Froggy111/filament-extruder/README.md

# Filament Extruder

fully closed loop FDM filameent production machine
