Froggy111/filament-extruder/hardware/control-board/control-board.kicad_pcb

## KiCad design hardware/control-board/control-board.kicad_pcb (2026-01-01)

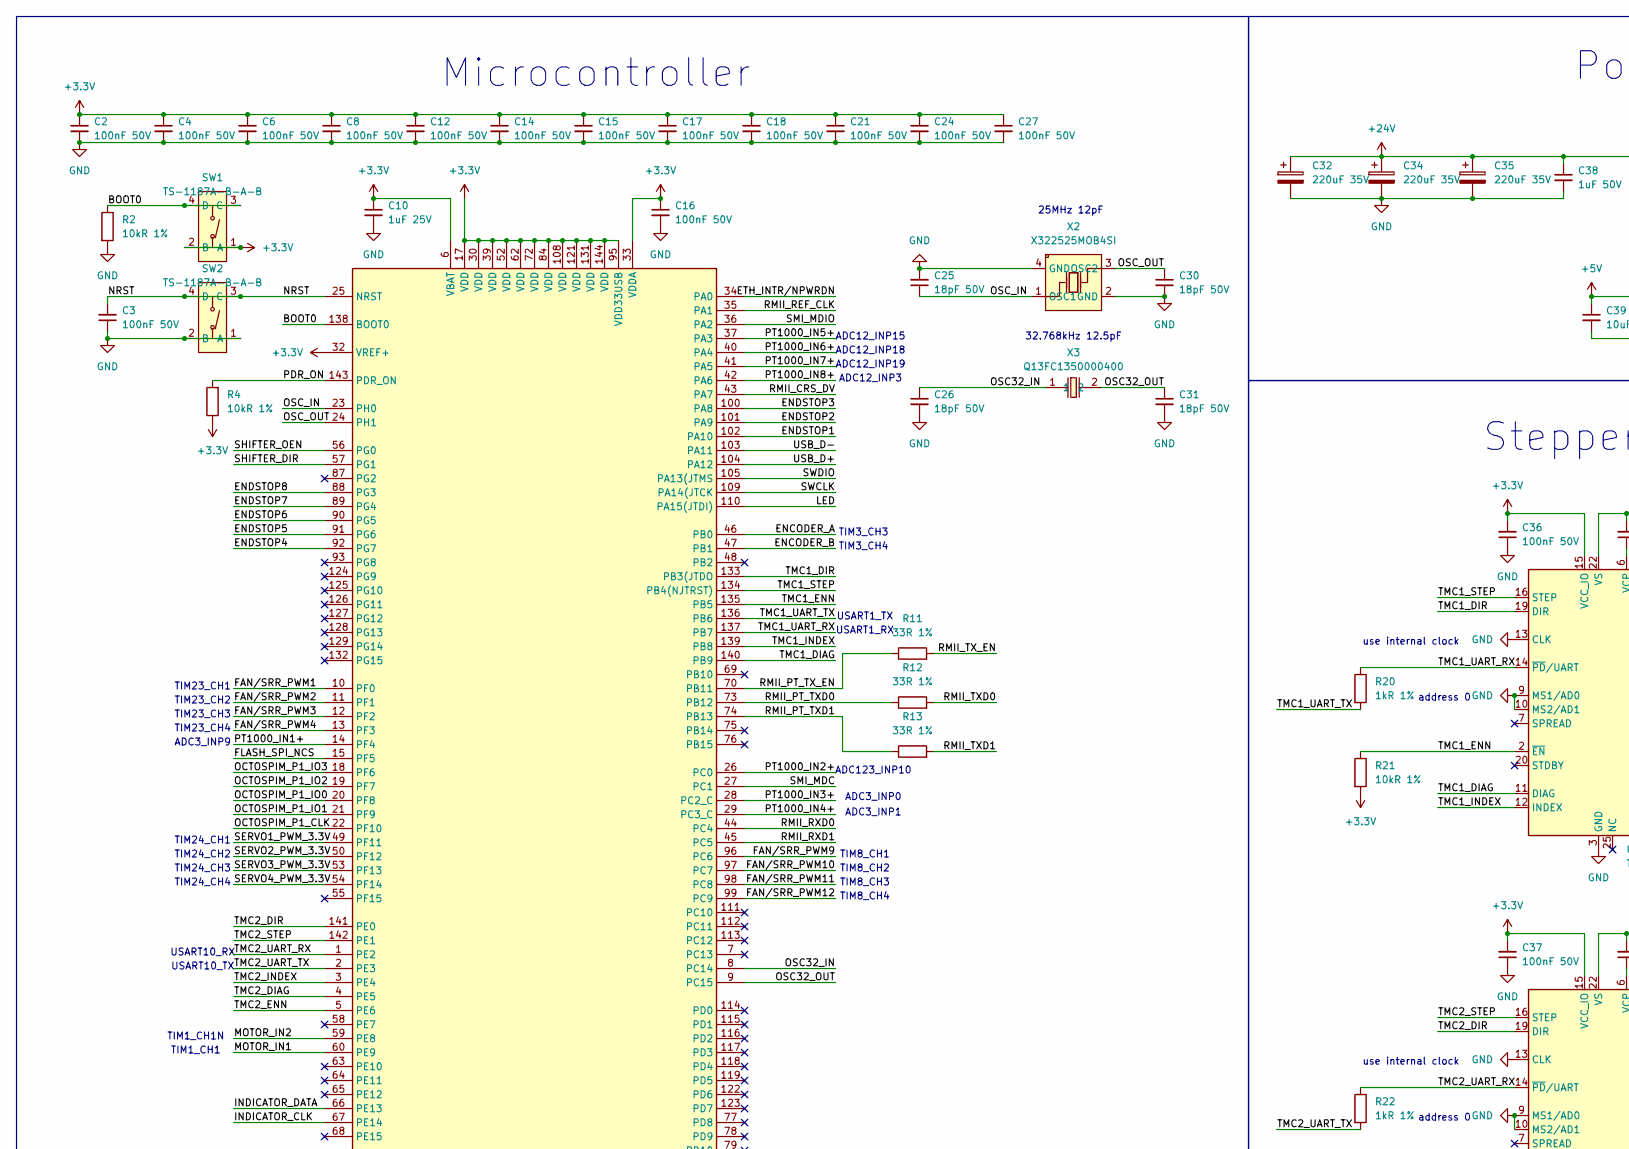
[picture p1: schematic control-board.kicad_sch, part in row 1, column 1]

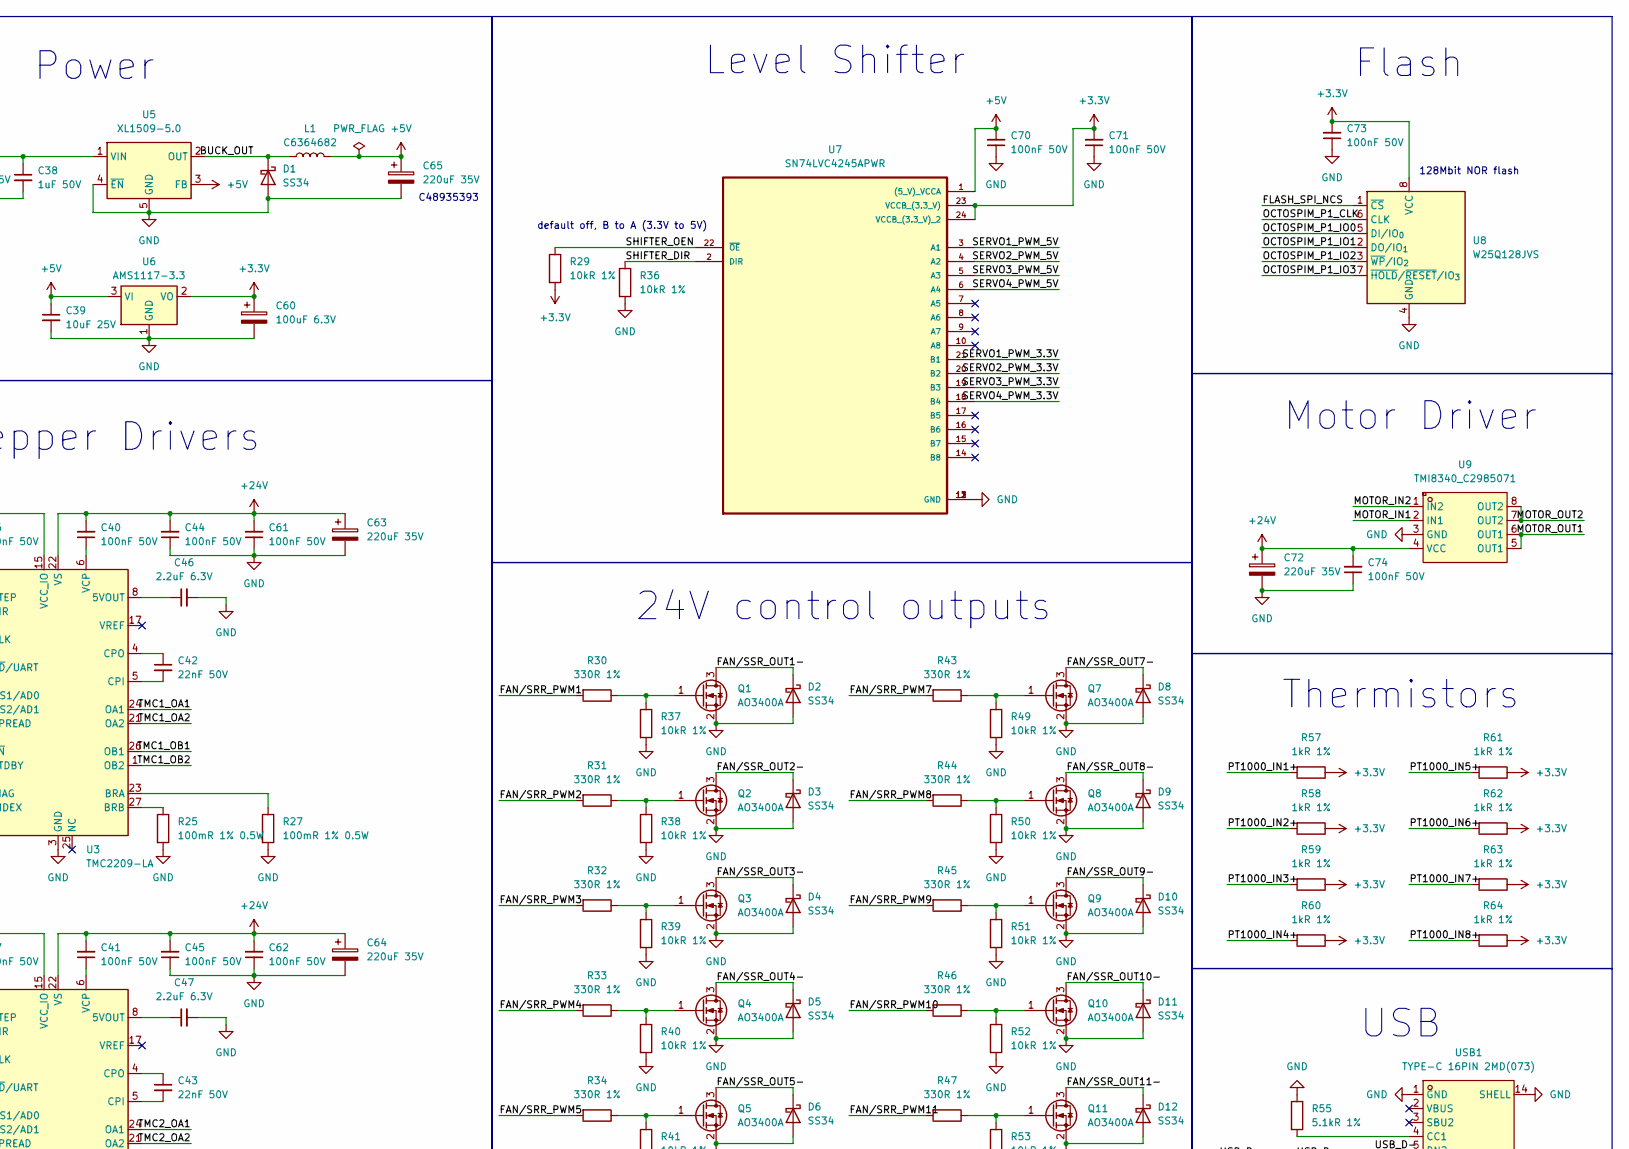
[picture p2: schematic control-board.kicad_sch, part in row 1, column 2]

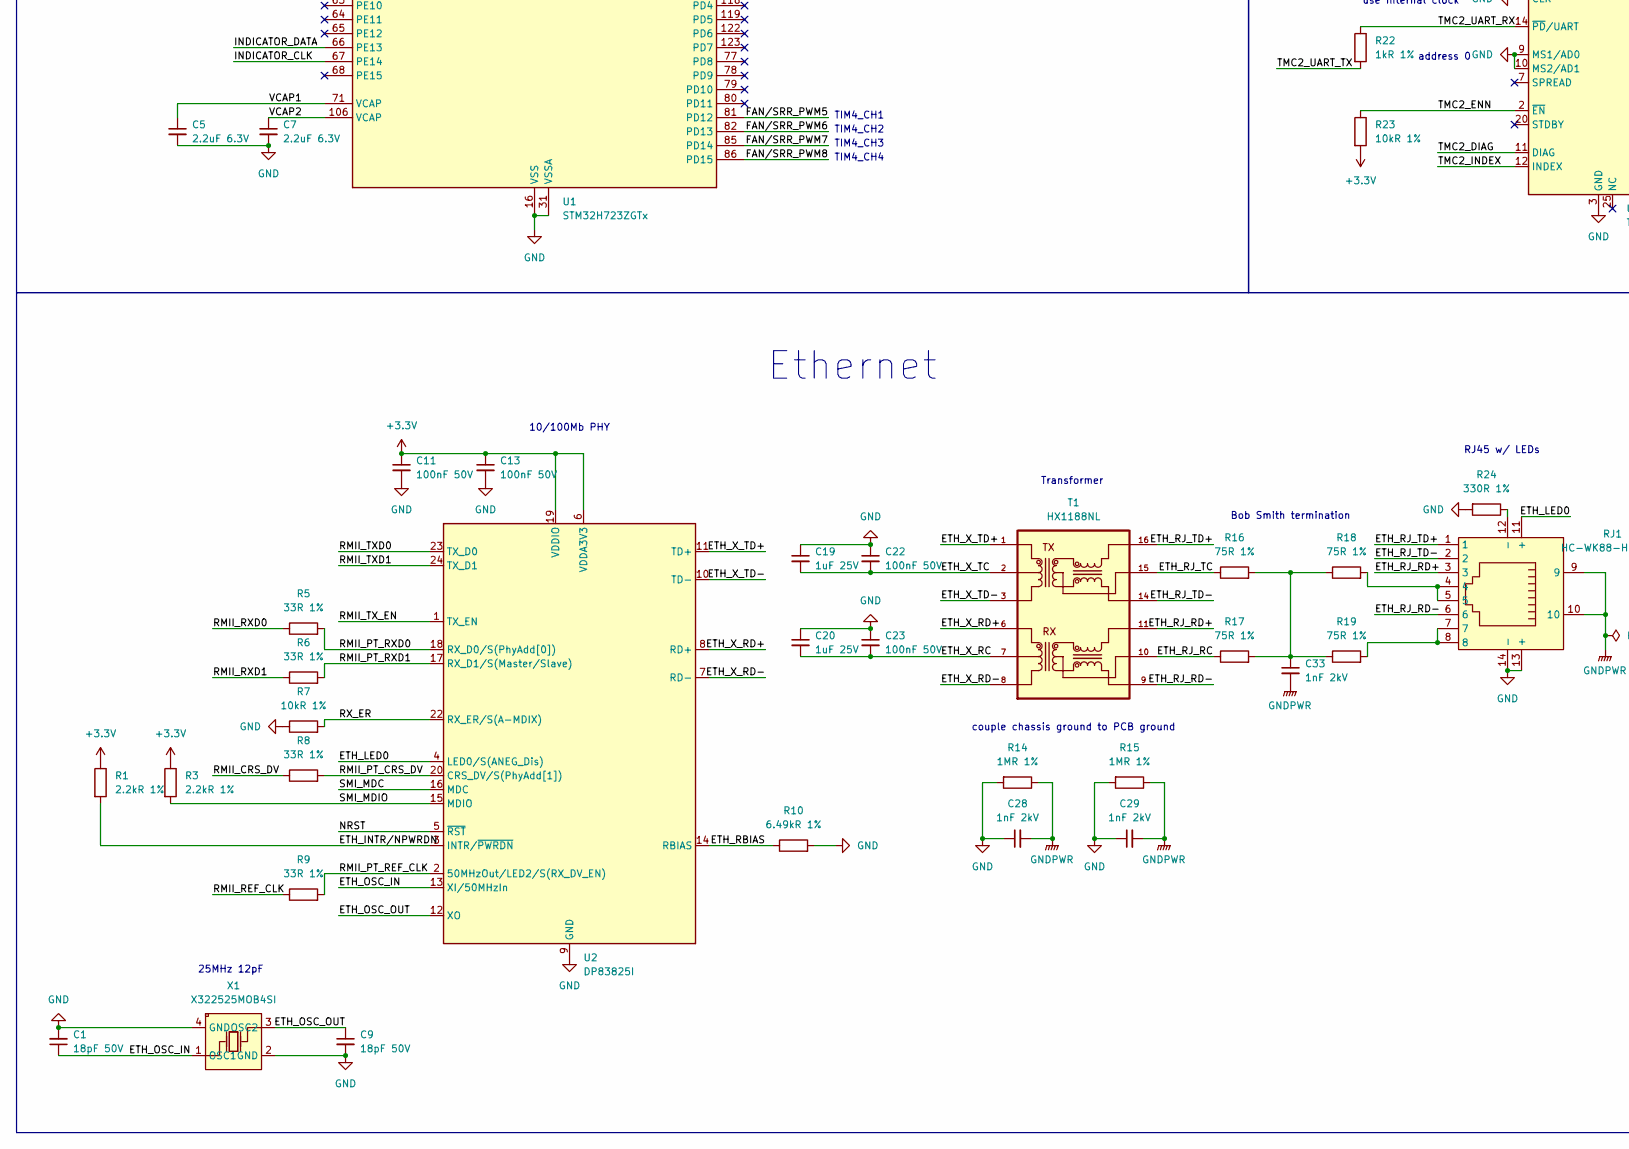
[picture p3: schematic control-board.kicad_sch, part in row 2, column 1]

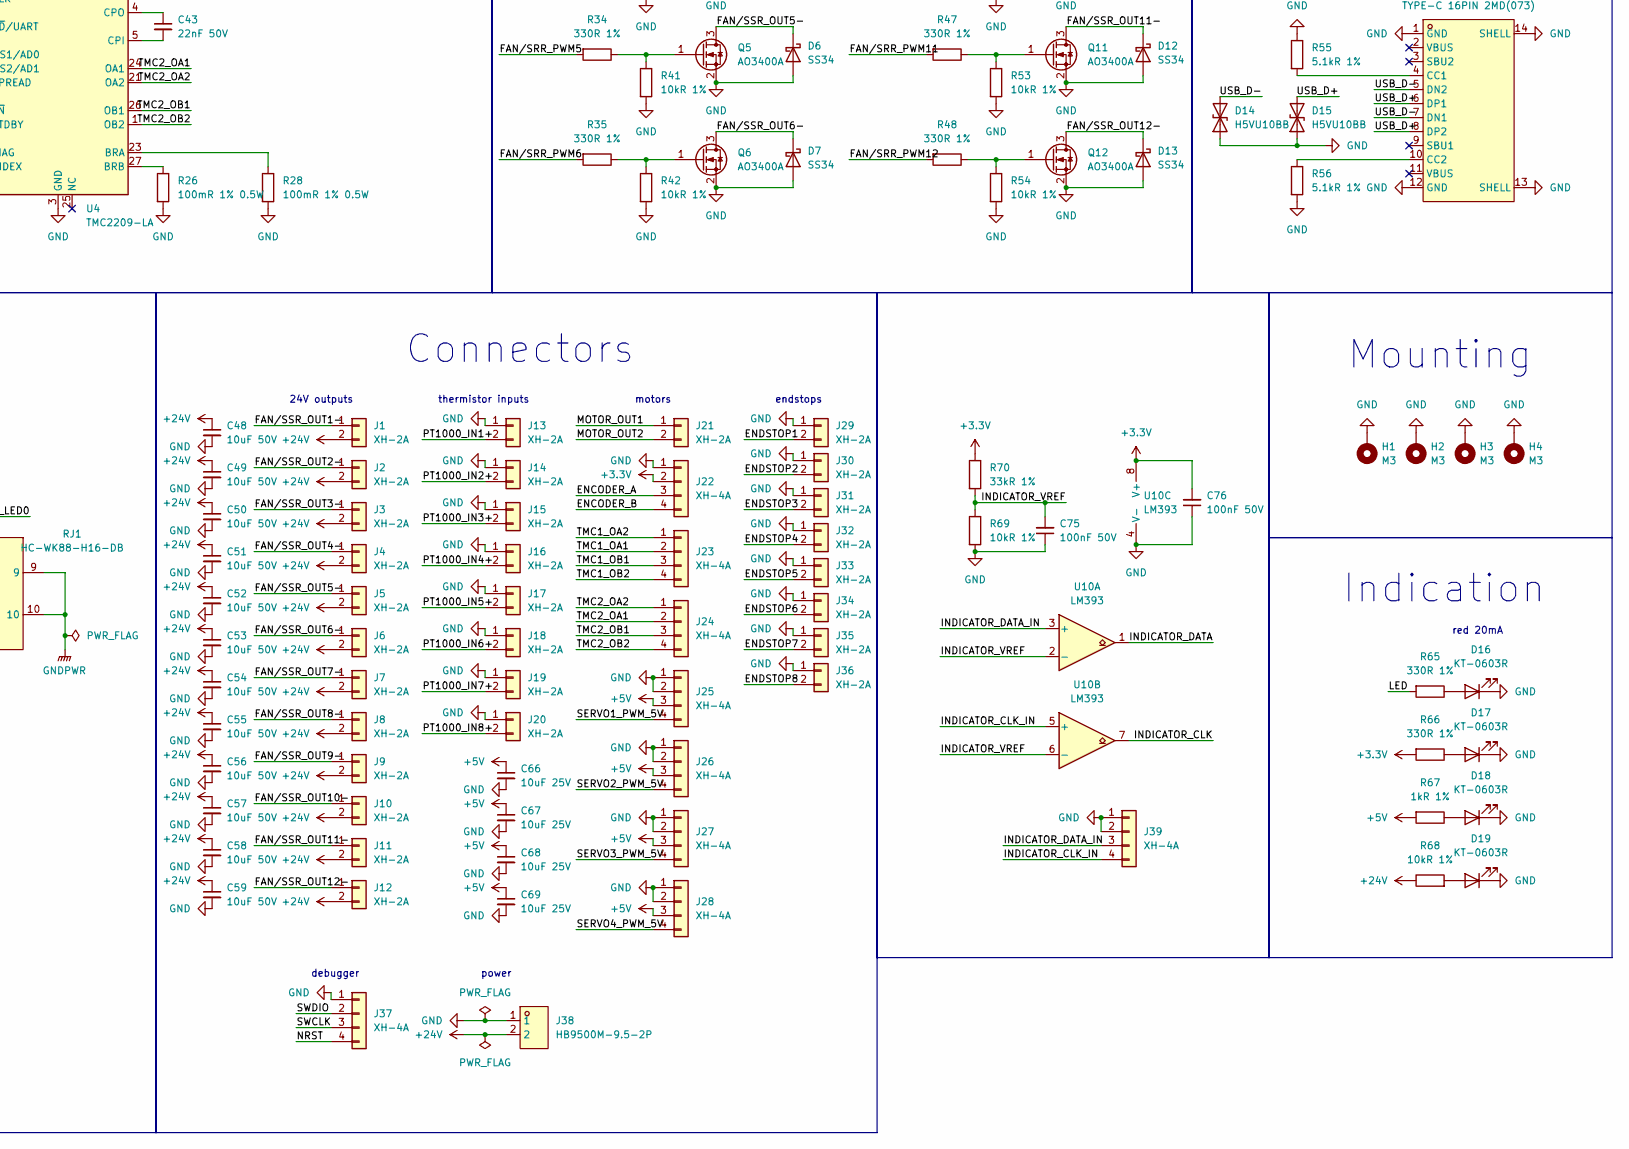
[picture p4: schematic control-board.kicad_sch, part in row 2, column 2]

Parts:
C1, C9, C25, C26, C30, C31: 18pF 50V; C_0402_1005Metric
C2, C3, C4, C6, C8, C11, C12, C13, C14, C15, C16, C17, C18, C21, C22, C23, C24, C27, C36, C37, C40, C41, C44, C45, C61, C62, C70, C71, C73, C74, C75, C76: 100nF 50V; C_0402_1005Metric
C5, C7, C46, C47: 2.2uF 6.3V; C_0402_1005Metric
C10, C19, C20: 1uF 25V; C_0402_1005Metric
C28, C29, C33: 1nF 2kV; C_1206_3216Metric
C32, C34, C35, C63, C64, C65, C72: 220uF 35V; CP_Elec_8x10.5
C38: 1uF 50V; C_0603_1608Metric
C39, C66, C67, C68, C69: 10uF 25V; C_0603_1608Metric
C42, C43: 22nF 50V; C_0402_1005Metric
C48, C49, C50, C51, C52, C53, C54, C55, C56, C57, C58, C59: 10uF 50V; C_1206_3216Metric
C60: 100uF 6.3V; CP_EIA-3528-21_Kemet-B
D1, D2, D3, D4, D5, D6, D7, D8, D9, D10, D11, D12, D13: SS34; D_SMA
D14, D15: H5VU10BB; D_SOD-882
D16, D17, D18, D19: KT-0603R; LED_0603_1608Metric
H1, H2, H3, H4: M3; MountingHole_3.2mm_M3_Pad_Via
J1, J2, J3, J4, J5, J6, J7, J8, J9, J10, J11, J12, J13, J14, J15, J16, J17, J18, J19, J20, J21, J29, J30, J31, J32, J33, J34, J35, J36: XH-2A; JST_XH_B2B-XH-A_1x02_P2.50mm_Vertical
J22, J23, J24, J25, J26, J27, J28, J37, J39: XH-4A; JST_XH_B4B-XH-A_1x04_P2.50mm_Vertical
J38: HB9500M-9.5-2P; CONN-TH_HB9500M-9.5-2P; LCSC Part C601239
L1: C6364682; L_Chilisin_BMRF00101040
Q1, Q2, Q3, Q4, Q5, Q6, Q7, Q8, Q9, Q10, Q11, Q12: AO3400A; SOT-23
R1, R3: 2.2kR 1%; R_0402_1005Metric
R2, R4, R7, R21, R23, R29, R36, R37, R38, R39, R40, R41, R42, R49, R50, R51, R52, R53, R54, R68, R69: 10kR 1%; R_0402_1005Metric
R5, R6, R8, R9, R11, R12, R13: 33R 1%; R_0402_1005Metric
R10: 6.49kR 1%; R_0402_1005Metric
R14, R15: 1MR 1%; R_1206_3216Metric
R16, R17, R18, R19: 75R 1%; R_0402_1005Metric
R20, R22, R57, R58, R59, R60, R61, R62, R63, R64, R67: 1kR 1%; R_0402_1005Metric
R24, R30, R31, R32, R33, R34, R35, R43, R44, R45, R46, R47, R48, R65, R66: 330R 1%; R_0402_1005Metric
R25, R26, R27, R28: 100mR 1% 0.5W; R_1206_3216Metric
R55, R56: 5.1kR 1%; R_0402_1005Metric
R70: 33kR 1%; R_0402_1005Metric
RJ1: HC-WK88-H16-DB; RJ45-TH_HC-WK88-H16-DB; LCSC Part C7501824
SW1, SW2: TS-1187A-B-A-B; SW-SMD_4P-L5.1-W5.1-P3.70-LS6.5-TL_H1.5; LCSC Part C318884
T1: HX1188NL; HXXXX
U1: STM32H723ZGTx; LQFP-144_20x20mm_P0.5mm
U2: DP83825I; Texas_RMQ0024A_WQFN-24-1EP_3x3mm_P0.4mm_EP1.9x1.9mm
U3, U4: TMC2209-LA; VQFN-28-1EP_5x5mm_P0.5mm_EP3.7x3.7mm_ThermalVias
U5: XL1509-5.0; SOIC-8_3.9x4.9mm_P1.27mm
U6: AMS1117-3.3; SOT-223-3_TabPin2
U7: SN74LVC4245APWR; SOP65P640X120-24N
U8: W25Q128JVS; SOIC-8_5.3x5.3mm_P1.27mm
U9: TMI8340_C2985071; SOP-8_L4.9-W3.9-P1.27-LS6.0-BL-1; LCSC Part C2985071
U10: LM393; SOIC-8_3.9x4.9mm_P1.27mm
USB1: TYPE-C 16PIN 2MD(073); USB-C-SMD_TYPE-C-6PIN-2MD-073; LCSC Part C2765186
X1, X2: X322525MOB4SI; CRYSTAL-SMD_4P-L3.2-W2.5-BL; LCSC Part C9006
X3: Q13FC1350000400; FC-135R_L3.2-W1.5; LCSC Part C32346

Connections:
+3.3V: C2.1, C4.1, C6.1, C8.1, C10.1, C11.1, C12.1, C13.1, C14.1, C15.1, C16.1, C17.1, C18.1, C21.1, C24.1, C27.1, C36.2, C37.2, C60.1, C71.2, C73.2, C76.2, J22.2, R1.1, R3.1, R4.1, R21.2, R23.2, R29.2, R57.1, R58.1, R59.1, R60.1, R61.1, R62.1, R63.1, R64.1, R66.2, R70.1, SW1.1 (A), SW1.2 (B), U1.6 (VBAT), U1.17 (VDD), U1.30 (VDD), U1.32 (VREF+), U1.33 (VDDA), U1.39 (VDD), U1.52 (VDD), U1.62 (VDD), U1.72 (VDD), U1.84 (VDD), U1.95 (VDD33USB), U1.108 (VDD), U1.121 (VDD), U1.131 (VDD), U1.144 (VDD), U2.6 (VDDA3V3), U2.19 (VDDIO), U3.15 (VCC_IO), U4.15 (VCC_IO), U6.2 (VO), U7.23 (VCCB_(3.3_V)), U7.24 (VCCB_(3.3_V)_2), U8.8 (VCC), U10.8 (V+)
+5V: C39.1, C65.1, C66.1, C67.1, C68.1, C69.1, C70.2, J25.3, J26.3, J27.3, J28.3, L1.2, R67.2, U5.3 (FB), U6.3 (VI), U7.1 ((5_V)_VCCA)
+24V: C32.1, C34.1, C35.1, C38.1, C40.2, C41.2, C44.2, C45.2, C48.1, C49.1, C50.1, C51.1, C52.1, C53.1, C54.1, C55.1, C56.1, C57.1, C58.1, C59.1, C61.2, C62.2, C63.1, C64.1, C72.1, C74.2, J1.2, J2.2, J3.2, J4.2, J5.2, J6.2, J7.2, J8.2, J9.2, J10.2, J11.2, J12.2, J38.2, R68.1, U3.22 (VS), U3.28 (VS), U4.22 (VS), U4.28 (VS), U5.1 (VIN), U9.4 (VCC)
/BOOT0: R2.1, SW1.3 (C), SW1.4 (D), U1.138 (BOOT0)
/BUCK_OUT: D1.1 (K), L1.1, U5.2 (OUT)
/ENCODER_A: J22.3, U1.46 (PB0)
/ENCODER_B: J22.4, U1.47 (PB1)
/ENDSTOP1: J29.2, U1.102 (PA10)
/ENDSTOP2: J30.2, U1.101 (PA9)
/ENDSTOP3: J31.2, U1.100 (PA8)
/ENDSTOP4: J32.2, U1.92 (PG7)
/ENDSTOP5: J33.2, U1.91 (PG6)
/ENDSTOP6: J34.2, U1.90 (PG5)
/ENDSTOP7: J35.2, U1.89 (PG4)
/ENDSTOP8: J36.2, U1.88 (PG3)
/ETH_INTR/NPWRDN: R1.2, U1.34 (PA0), U2.3 (INTR/~PWRDN)
/ETH_LED0: RJ1.11 (+), U2.4 (LED0/S(ANEG_Dis))
/ETH_OSC_IN: C1.1, U2.13 (XI/50MHzIn), X1.1 (OSC1)
/ETH_OSC_OUT: C9.1, U2.12 (XO), X1.3 (OSC2)
/ETH_RBIAS: R10.1, U2.14 (RBIAS)
/ETH_RJ_RC: R17.1, T1.10
/ETH_RJ_RD+: RJ1.3, T1.11
/ETH_RJ_RD-: RJ1.6, T1.9
/ETH_RJ_TC: R16.1, T1.15
/ETH_RJ_TD+: RJ1.1, T1.16
/ETH_RJ_TD-: RJ1.2, T1.14
/ETH_X_RC: C20.2, C23.2, T1.7
/ETH_X_RD+: T1.6, U2.8 (RD+)
/ETH_X_RD-: T1.8, U2.7 (RD-)
/ETH_X_TC: C19.2, C22.2, T1.2
/ETH_X_TD+: T1.1, U2.11 (TD+)
/ETH_X_TD-: T1.3, U2.10 (TD-)
/FAN/SRR_PWM1: R30.2, U1.10 (PF0)
/FAN/SRR_PWM2: R31.2, U1.11 (PF1)
/FAN/SRR_PWM3: R32.2, U1.12 (PF2)
/FAN/SRR_PWM4: R33.2, U1.13 (PF3)
/FAN/SRR_PWM5: R34.2, U1.81 (PD12)
/FAN/SRR_PWM6: R35.2, U1.82 (PD13)
/FAN/SRR_PWM7: R43.2, U1.85 (PD14)
/FAN/SRR_PWM8: R44.2, U1.86 (PD15)
/FAN/SRR_PWM9: R45.2, U1.96 (PC6)
/FAN/SRR_PWM10: R46.2, U1.97 (PC7)
/FAN/SRR_PWM11: R47.2, U1.98 (PC8)
/FAN/SRR_PWM12: R48.2, U1.99 (PC9)
/FAN/SSR_OUT1-: D2.1 (K), J1.1, Q1.3 (D)
/FAN/SSR_OUT2-: D3.1 (K), J2.1, Q2.3 (D)
/FAN/SSR_OUT3-: D4.1 (K), J3.1, Q3.3 (D)
/FAN/SSR_OUT4-: D5.1 (K), J4.1, Q4.3 (D)
/FAN/SSR_OUT5-: D6.1 (K), J5.1, Q5.3 (D)
/FAN/SSR_OUT6-: D7.1 (K), J6.1, Q6.3 (D)
/FAN/SSR_OUT7-: D8.1 (K), J7.1, Q7.3 (D)
/FAN/SSR_OUT8-: D9.1 (K), J8.1, Q8.3 (D)
/FAN/SSR_OUT9-: D10.1 (K), J9.1, Q9.3 (D)
/FAN/SSR_OUT10-: D11.1 (K), J10.1, Q10.3 (D)
/FAN/SSR_OUT11-: D12.1 (K), J11.1, Q11.3 (D)
/FAN/SSR_OUT12-: D13.1 (K), J12.1, Q12.3 (D)
/FLASH_SPI_NCS: U1.15 (PF5), U8.1 (~CS)
/INDICATOR_CLK: U1.67 (PE14), U10.7
/INDICATOR_CLK_IN: J39.4, U10.5 (+)
/INDICATOR_DATA: U1.66 (PE13), U10.1
/INDICATOR_DATA_IN: J39.3, U10.3 (+)
/INDICATOR_VREF: C75.2, R69.1, R70.2, U10.2 (-), U10.6 (-)
/LED: R65.2, U1.110 (PA15(JTDI))
/MOTOR_IN1: U1.60 (PE9), U9.2 (IN1)
/MOTOR_IN2: U1.59 (PE8), U9.1 (IN2)
/MOTOR_OUT1: J21.1, U9.5 (OUT1), U9.6 (OUT1)
/MOTOR_OUT2: J21.2, U9.7 (OUT2), U9.8 (OUT2)
/NRST: C3.2, J37.4, SW2.3 (C), SW2.4 (D), U1.25 (NRST), U2.5 (~RST)
/OCTOSPIM_P1_CLK: U1.22 (PF10), U8.6 (CLK)
/OCTOSPIM_P1_IO0: U1.20 (PF8), U8.5 (DI/IO_{0})
/OCTOSPIM_P1_IO1: U1.21 (PF9), U8.2 (DO/IO_{1})
/OCTOSPIM_P1_IO2: U1.19 (PF7), U8.3 (~WP/IO_{2})
/OCTOSPIM_P1_IO3: U1.18 (PF6), U8.7 (~HOLD/~RESET/IO_{3})
/OSC32_IN: C26.1, U1.8 (PC14), X3.1
/OSC32_OUT: C31.1, U1.9 (PC15), X3.2
/OSC_IN: C25.1, U1.23 (PH0), X2.1 (OSC1)
/OSC_OUT: C30.1, U1.24 (PH1), X2.3 (OSC2)
/PDR_ON: R4.2, U1.143 (PDR_ON)
/PT1000_IN1+: J13.2, R57.2, U1.14 (PF4)
/PT1000_IN2+: J14.2, R58.2, U1.26 (PC0)
/PT1000_IN3+: J15.2, R59.2, U1.28 (PC2_C)
/PT1000_IN4+: J16.2, R60.2, U1.29 (PC3_C)
/PT1000_IN5+: J17.2, R61.2, U1.37 (PA3)
/PT1000_IN6+: J18.2, R62.2, U1.40 (PA4)
/PT1000_IN7+: J19.2, R63.2, U1.41 (PA5)
/PT1000_IN8+: J20.2, R64.2, U1.42 (PA6)
/RMII_CRS_DV: R8.1, U1.43 (PA7)
/RMII_PT_CRS_DV: R8.2, U2.20 (CRS_DV/S(PhyAdd[1]))
/RMII_PT_REF_CLK: R9.2, U2.2 (50MHzOut/LED2/S(RX_DV_EN))
/RMII_PT_RXD0: R5.2, U2.18 (RX_D0/S(PhyAdd[0]))
/RMII_PT_RXD1: R6.2, U2.17 (RX_D1/S(Master/Slave))
/RMII_PT_TXD0: R12.1, U1.73 (PB12)
/RMII_PT_TXD1: R13.1, U1.74 (PB13)
/RMII_PT_TX_EN: R11.1, U1.70 (PB11)
/RMII_REF_CLK: R9.1, U1.35 (PA1)
/RMII_RXD0: R5.1, U1.44 (PC4)
/RMII_RXD1: R6.1, U1.45 (PC5)
/RMII_TXD0: R12.2, U2.23 (TX_D0)
/RMII_TXD1: R13.2, U2.24 (TX_D1)
/RMII_TX_EN: R11.2, U2.1 (TX_EN)
/RX_ER: R7.2, U2.22 (RX_ER/S(A-MDIX))
/SERVO1_PWM_3.3V: U1.49 (PF11), U7.21 (B1)
/SERVO1_PWM_5V: J25.4, U7.3 (A1)
/SERVO2_PWM_3.3V: U1.50 (PF12), U7.20 (B2)
/SERVO2_PWM_5V: J26.4, U7.4 (A2)
/SERVO3_PWM_3.3V: U1.53 (PF13), U7.19 (B3)
/SERVO3_PWM_5V: J27.4, U7.5 (A3)
/SERVO4_PWM_3.3V: U1.54 (PF14), U7.18 (B4)
/SERVO4_PWM_5V: J28.4, U7.6 (A4)
/SHIFTER_DIR: R36.1, U1.57 (PG1), U7.2 (DIR)
/SHIFTER_OEN: R29.1, U1.56 (PG0), U7.22 (~OE)
/SMI_MDC: U1.27 (PC1), U2.16 (MDC)
/SMI_MDIO: R3.2, U1.36 (PA2), U2.15 (MDIO)
/SWCLK: J37.3, U1.109 (PA14(JTCK)
/SWDIO: J37.2, U1.105 (PA13(JTMS)
/TMC1_DIAG: U1.140 (PB9), U3.11 (DIAG)
/TMC1_DIR: U1.133 (PB3(JTDO), U3.19 (DIR)
/TMC1_ENN: R21.1, U1.135 (PB5), U3.2 (~EN)
/TMC1_INDEX: U1.139 (PB8), U3.12 (INDEX)
/TMC1_OA1: J23.2, U3.24 (OA1)
/TMC1_OA2: J23.1, U3.21 (OA2)
/TMC1_OB1: J23.3, U3.26 (OB1)
/TMC1_OB2: J23.4, U3.1 (OB2)
/TMC1_STEP: U1.134 (PB4(NJTRST)), U3.16 (STEP)
/TMC1_UART_RX: R20.1, U1.137 (PB7), U3.14 (~PD/UART)
/TMC1_UART_TX: R20.2, U1.136 (PB6)
/TMC2_DIAG: U1.4 (PE5), U4.11 (DIAG)
/TMC2_DIR: U1.141 (PE0), U4.19 (DIR)
/TMC2_ENN: R23.1, U1.5 (PE6), U4.2 (~EN)
/TMC2_INDEX: U1.3 (PE4), U4.12 (INDEX)
/TMC2_OA1: J24.2, U4.24 (OA1)
/TMC2_OA2: J24.1, U4.21 (OA2)
/TMC2_OB1: J24.3, U4.26 (OB1)
/TMC2_OB2: J24.4, U4.1 (OB2)
/TMC2_STEP: U1.142 (PE1), U4.16 (STEP)
/TMC2_UART_RX: R22.1, U1.1 (PE2), U4.14 (~PD/UART)
/TMC2_UART_TX: R22.2, U1.2 (PE3)
/USB_D+: D15.2 (A2), U1.104 (PA12), USB1.6 (DP1), USB1.8 (DP2)
/USB_D-: D14.2 (A2), U1.103 (PA11), USB1.5 (DN2), USB1.7 (DN1)
/VCAP1: C5.1, U1.71 (VCAP)
/VCAP2: C7.1, U1.106 (VCAP)
GND: C1.2, C2.2, C3.1, C4.2, C5.2, C6.2, C7.2, C8.2, C9.2, C10.2, C11.2, C12.2, C13.2, C14.2, C15.2, C16.2, C17.2, C18.2, C19.1, C20.1, C21.2, C22.1, C23.1, C24.2, C25.2, C26.2, C27.2, C28.1, C29.1, C30.2, C31.2, C32.2, C34.2, C35.2, C36.1, C37.1, C38.2, C39.2, C44.1, C45.1, C46.2, C47.2, C48.2, C49.2, C50.2, C51.2, C52.2, C53.2, C54.2, C55.2, C56.2, C57.2, C58.2, C59.2, C60.2, C61.1, C62.1, C63.2, C64.2, C65.2, C66.2, C67.2, C68.2, C69.2, C70.1, C71.1, C72.2, C73.1, C74.1, C75.1, C76.1, D1.2 (A), D2.2 (A), D3.2 (A), D4.2 (A), D5.2 (A), D6.2 (A), D7.2 (A), D8.2 (A), D9.2 (A), D10.2 (A), D11.2 (A), D12.2 (A), D13.2 (A), D14.1 (A1), D15.1 (A1), D16.1 (K), D17.1 (K), D18.1 (K), D19.1 (K), H1.1, H2.1, H3.1, H4.1, J13.1, J14.1, J15.1, J16.1, J17.1, J18.1, J19.1, J20.1, J22.1, J25.1, J25.2, J26.1, J26.2, J27.1, J27.2, J28.1, J28.2, J29.1, J30.1, J31.1, J32.1, J33.1, J34.1, J35.1, J36.1, J37.1, J38.1, J39.1, J39.2, Q1.2 (S), Q2.2 (S), Q3.2 (S), Q4.2 (S), Q5.2 (S), Q6.2 (S), Q7.2 (S), Q8.2 (S), Q9.2 (S), Q10.2 (S), Q11.2 (S), Q12.2 (S), R2.2, R7.1, R10.2, R14.2, R15.2, R24.2, R25.2, R26.2, R27.2, R28.2, R36.2, R37.2, R38.2, R39.2, R40.2, R41.2, R42.2, R49.2, R50.2, R51.2, R52.2, R53.2, R54.2, R55.1, R56.2, R69.2, RJ1.13 (+), RJ1.14 (-), SW2.1 (A), SW2.2 (B), U1.16 (VSS), U1.31 (VSSA), U1.38 (VSS), U1.51 (VSS), U1.61 (VSS), U1.83 (VSS), U1.94 (VSS), U1.107 (VSS), U1.120 (VSS), U1.130 (VSS), U2.9 (GND), U2.21 (GND), U2.25 (GND), U3.3 (GND), U3.9 (MS1/AD0), U3.10 (MS2/AD1), U3.13 (CLK), U3.18 (GND), U3.29 (GND), U4.3 (GND), U4.9 (MS1/AD0), U4.10 (MS2/AD1), U4.13 (CLK), U4.18 (GND), U4.29 (GND), U5.4 (~EN), U5.5 (GND), U5.6 (GND), U5.7 (GND), U5.8 (GND), U6.1 (GND), U7.11 (GND), U7.12 (GND), U7.13 (GND), U8.4 (GND), U9.3 (GND), U10.4 (V-), USB1.1 (GND), USB1.12 (GND), USB1.13 (SHELL), USB1.14 (SHELL), X1.2 (GND), X1.4 (GND), X2.2 (GND), X2.4 (GND)
GNDPWR: C28.2, C29.2, C33.2, R14.1, R15.1, RJ1.9, RJ1.10
unnamed: C33.1, R16.2, R17.2, R18.1, R19.1
unnamed: D16.2 (A), R65.1
unnamed: D17.2 (A), R66.1
unnamed: D18.2 (A), R67.1
unnamed: D19.2 (A), R68.2
unnamed: Q1.1 (G), R30.1, R37.1
unnamed: Q2.1 (G), R31.1, R38.1
unnamed: Q3.1 (G), R32.1, R39.1
unnamed: Q4.1 (G), R33.1, R40.1
unnamed: Q5.1 (G), R34.1, R41.1
unnamed: Q6.1 (G), R35.1, R42.1
unnamed: Q7.1 (G), R43.1, R49.1
unnamed: Q8.1 (G), R44.1, R50.1
unnamed: Q9.1 (G), R45.1, R51.1
unnamed: Q10.1 (G), R46.1, R52.1
unnamed: Q11.1 (G), R47.1, R53.1
unnamed: Q12.1 (G), R48.1, R54.1
unnamed: R18.2, RJ1.4, RJ1.5
unnamed: R19.2, RJ1.7, RJ1.8
unnamed: R24.1, RJ1.12 (-)
unnamed: C46.1, U3.8 (5VOUT)
unnamed: R27.1, U3.23 (BRA)
unnamed: R25.1, U3.27 (BRB)
unnamed: C42.2, U3.5 (CPI)
unnamed: C42.1, U3.4 (CPO)
unnamed: C40.1, U3.6 (VCP)
unnamed: C47.1, U4.8 (5VOUT)
unnamed: R28.1, U4.23 (BRA)
unnamed: R26.1, U4.27 (BRB)
unnamed: C43.2, U4.5 (CPI)
unnamed: C43.1, U4.4 (CPO)
unnamed: C41.1, U4.6 (VCP)
unnamed: R55.2, USB1.4 (CC1)
unnamed: R56.1, USB1.10 (CC2)

Notes on the sheet:
TIM3_CH3
Indication
use internal clock
Power
address 0
TIM23_CH3
TIM8_CH4
25MHz 12pF
Connectors
TIM24_CH2
ADC3_INP0
TIM1_CH1
ADC3_INP1
TIM4_CH1
128Mbit NOR flash
TIM8_CH2
ADC12_INP3
TIM8_CH1
TIM1_CH1N
32.768kHz 12.5pF
ADC12_INP15
ADC3_INP9
24V control outputs
Microcontroller
C48935393
USART1_RX
TIM4_CH2
Bob Smith termination
24V outputs
USART10_TX
Level Shifter
10/100Mb PHY
Ethernet
USART10_RX
TIM8_CH3
Motor Driver
TIM4_CH3
TIM24_CH4
TIM23_CH1
Thermistors
Mounting
endstops
TIM23_CH4
red 20mA
USB
couple chassis ground to PCB ground
TIM23_CH2
TIM4_CH4
TIM24_CH3
Stepper Drivers
Flash
default off, B to A (3.3V to 5V)
motors
ADC123_INP10
TIM3_CH4
TIM24_CH1
ADC12_INP18
USART1_TX
debugger
thermistor inputs
RJ45 w/ LEDs
ADC12_INP19
Transformer
power

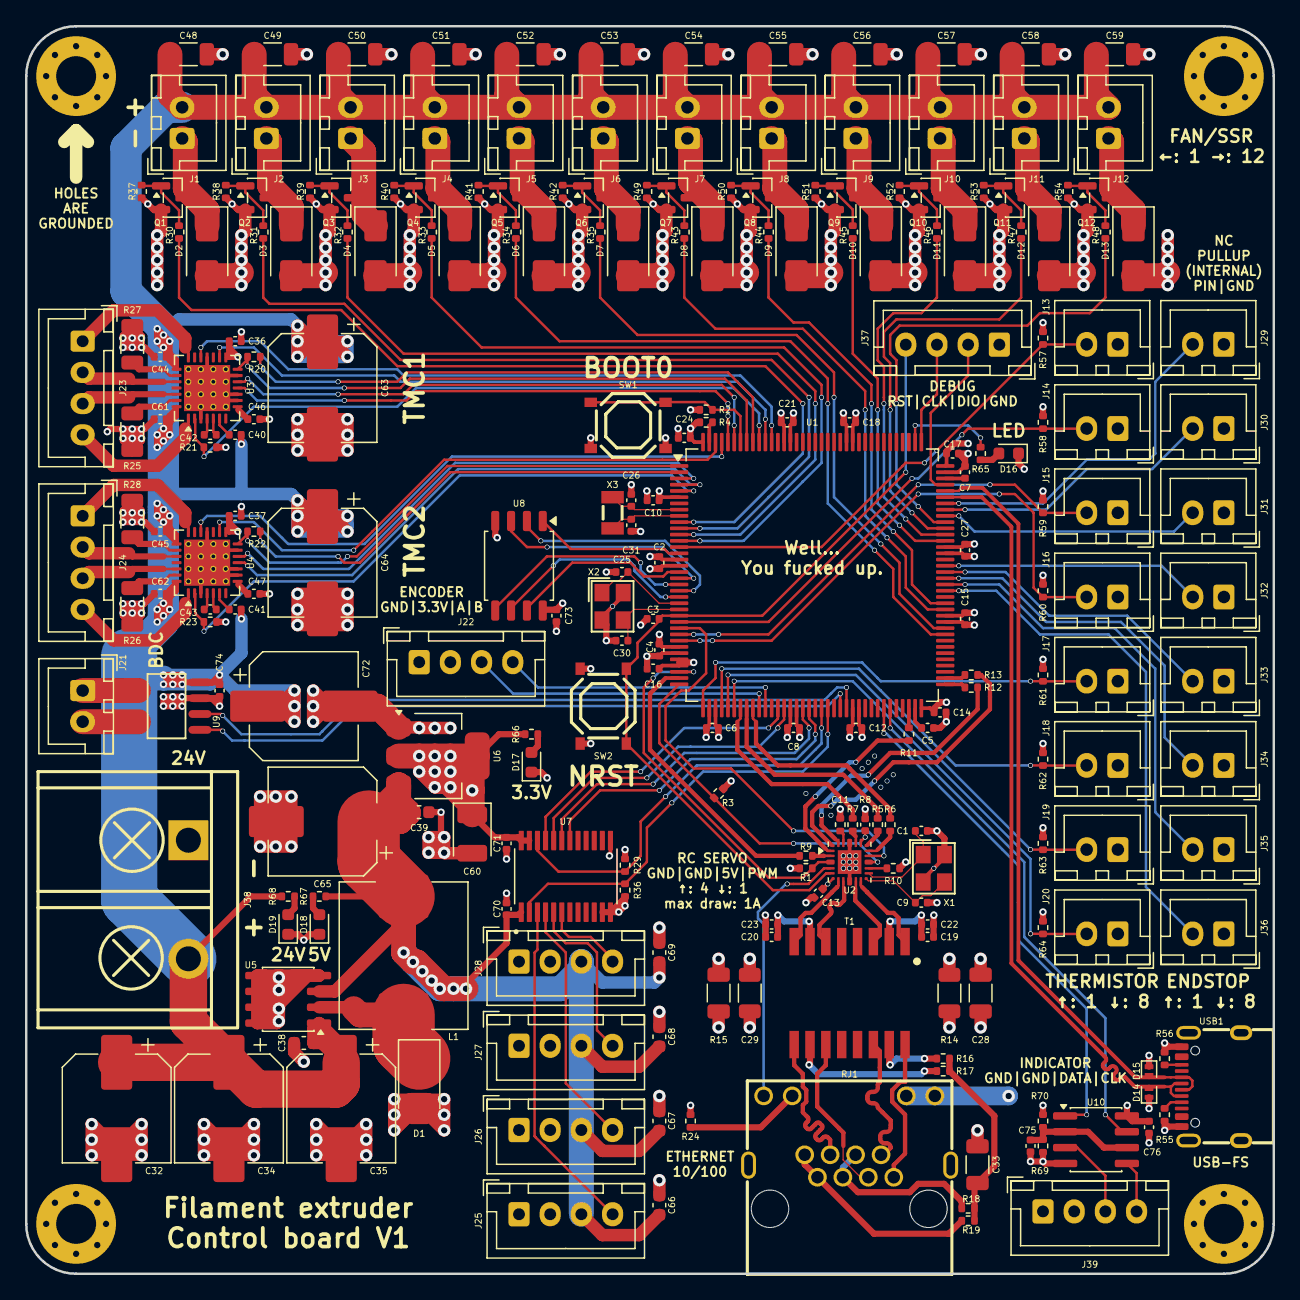
[picture p5: board control-board.kicad_pcb from above]

Board: 4 copper layers, 100.0 x 100.0 mm, 239 parts (0 on the bottom side), 177 nets.
