Froggy111/filament-extruder/software/firmware/main/src/clock/systick.cpp

#include <stm32h7xx_hal.h>

#include "clock.hpp"

// NOTE : Uses TIM2 for SysTick, as recommended when using an RTOS

extern "C" {

TIM_HandleTypeDef systick_timer;

/**
 * @brief  This function configures the TIM2 as a time base source.
 *         The time source is configured  to have 1ms time base with a dedicated
 *         Tick interrupt priority.
 * @note   This function is called  automatically at the beginning of program
 * after reset by HAL_Init() or at any time when clock is configured, by
 * HAL_RCC_ClockConfig().
 * @param  TickPriority: Tick interrupt priority.
 * @retval HAL status
 */
HAL_StatusTypeDef HAL_InitTick(uint32_t TickPriority) {
    RCC_ClkInitTypeDef clkconfig;
    uint32_t uwTimclock = 0;
    uint32_t uwPrescalerValue = 0;
    uint32_t pFLatency;

    HAL_StatusTypeDef status;

    /* Enable TIM2 clock */
    __HAL_RCC_TIM2_CLK_ENABLE();

    /* Get clock configuration */
    HAL_RCC_GetClockConfig(&clkconfig, &pFLatency);

    /* Compute TIM2 clock */
    uwTimclock = HAL_RCC_GetPCLK1Freq() * 2;

    /* Compute the prescaler value to have TIM2 counter clock equal to 1MHz */
    uwPrescalerValue = (uint32_t)((uwTimclock / 1000000U) - 1U);

    /* Initialize TIM2 */
    systick_timer.Instance = TIM2;

    /* Initialize TIMx peripheral as follow:

    + Period = [(TIM2CLK/1000) - 1]. to have a (1/1000) s time base.
    + Prescaler = (uwTimclock/1000000 - 1) to have a 1MHz counter clock.
    + ClockDivision = 0
    + Counter direction = Up
    */
    systick_timer.Init.Period = (1000000U / 1000U) - 1U;
    systick_timer.Init.Prescaler = uwPrescalerValue;
    systick_timer.Init.ClockDivision = 0;
    systick_timer.Init.CounterMode = TIM_COUNTERMODE_UP;

    status = HAL_TIM_Base_Init(&systick_timer);
    if (status == HAL_OK) {
        /* Start the TIM time Base generation in interrupt mode */
        status = HAL_TIM_Base_Start_IT(&systick_timer);
        if (status == HAL_OK) {
            /* Enable the TIM2 global Interrupt */
            HAL_NVIC_EnableIRQ(TIM2_IRQn);
            /* Configure the SysTick IRQ priority */
            if (TickPriority < (1UL << __NVIC_PRIO_BITS)) {
                /* Configure the TIM IRQ priority */
                HAL_NVIC_SetPriority(TIM2_IRQn, TickPriority, 0U);
                uwTickPrio = TickPriority;
            } else {
                status = HAL_ERROR;
            }
        }
    }

    /* Return function status */
    return status;
}

/**
 * @brief  Suspend Tick increment.
 * @note   Disable the tick increment by disabling TIM2 update interrupt.
 * @param  None
 * @retval None
 */
void HAL_SuspendTick(void) {
    /* Disable TIM2 update Interrupt */
    __HAL_TIM_DISABLE_IT(&systick_timer, TIM_IT_UPDATE);
}

/**
 * @brief  Resume Tick increment.
 * @note   Enable the tick increment by Enabling TIM2 update interrupt.
 * @param  None
 * @retval None
 */
void HAL_ResumeTick(void) {
    /* Enable TIM2 Update interrupt */
    __HAL_TIM_ENABLE_IT(&systick_timer, TIM_IT_UPDATE);
}
}

void clock::systick_handler(void) { HAL_TIM_IRQHandler(&systick_timer); }
