Froggy111/filament-extruder/software/firmware/main/src/configs/configs/clock.hpp

#pragma once
#include <stm32h7xx_hal.h>

const uint32_t SYSCLK_FREQ = 550e6;       // 550MHz
const uint32_t TIMER_INPUT_FREQ = 275e6;  // 275MHz
const uint32_t ADC_INPUT_FREQ = 48e6;     // 48MHz
const uint32_t QSPI_INPUT_FREQ = 160e6;   // 160MHz
const uint32_t UART_INPUT_FREQ = 1375e5;  // 137.5MHz
