Froggy111/filament-extruder/(commit log)

2025-12-03 control board complete
    [control-board.kicad_pcb, control-board.kicad_sch]
2025-12-03 added indicator I/O, text labels
    [control-board.kicad_pcb, control-board.kicad_sch]
2025-12-03 production files
    [bom.csv, designators.csv, positions.csv]
2025-12-03 changed ethernet termination capacitors to 1nF
    [bom.csv, control-board.kicad_pcb, control-board.kicad_sch]
2026-01-01 led blinks
    [control-board.kicad_pcb]
2026-01-28 FAN/SSR control
2026-01-28 fan off below
2026-01-31 tmc2209 UART conf
2026-02-01 stepper timer
2026-02-09 thermistor fixed
2026-02-17 webpage + heater + puller
